BilbaoDynamics/Pinchy/Software/Draw_Matrix/README.md

# Draw Pinchy 

<blockquote class="twitter-tweet" data-lang="es"><p lang="es" dir="ltr">Haciendo integrales en la matriz de <a href="https://twitter.com/hashtag/Pinchy?src=hash">#Pinchy</a> <a href="https://twitter.com/hashtag/teleco?src=hash">#teleco</a> <a href="https://twitter.com/hashtag/PinchyOfThings?src=hash">#PinchyOfThings</a> <a href="https://twitter.com/MakerFaireBio">@MakerFaireBio</a> <a href="https://twitter.com/BilbaoDynamics">@BilbaoDynamics</a> <a href="https://t.co/CbgPX1H6TI">pic.twitter.com/CbgPX1H6TI</a></p>&mdash; Eneko Montero (@EnekoMontero) <a href="https://twitter.com/EnekoMontero/status/799953861096144896">19 de noviembre de 2016</a></blockquote> <script async src="//platform.twitter.com/widgets.js" charset="utf-8"></script>

Program to draw on Pinchy's matrix using your phone.
