BilbaoDynamics/Pinchy/(threads)

Thread 2 (2016-09-29):

Archivos fuentes partes impresas

hulkco, 2016-09-29:
Hola, gracias por compartir su proyecto, podrian compartir los ficheros fuente de las partes impresas y la medida de la Matriz de Leds, gracias

BilbaoDynamics, 2016-09-29:
Buenas tardes Gustavo,

Ante todo muchas gracias por interesarte en el desarrollo de nuestro proyecto. Todos los archivos imprimibles necesarios están en la carpeta Chasis (https://github.com/BilbaoDynamics/Pinchy/tree/master/Chasis). En cuanto a la matriz de LEDs, el driver que utilizamos es este (https://www.sparkfun.com/datasheets/Components/General/COM-09622-MAX7219-MAX7221.pdf) y la matriz esta (https://www.dropbox.com/s/1uju2v4d2x47efw/matriz.pdf?dl=0).

Un saludo, BD team.

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

Closed 2016-09-29.
