BilbaoDynamics/Pinchy/Circuitos/Matrix/matrix.brd

## EAGLE design Circuitos/Matrix/matrix.brd (2016-11-18)

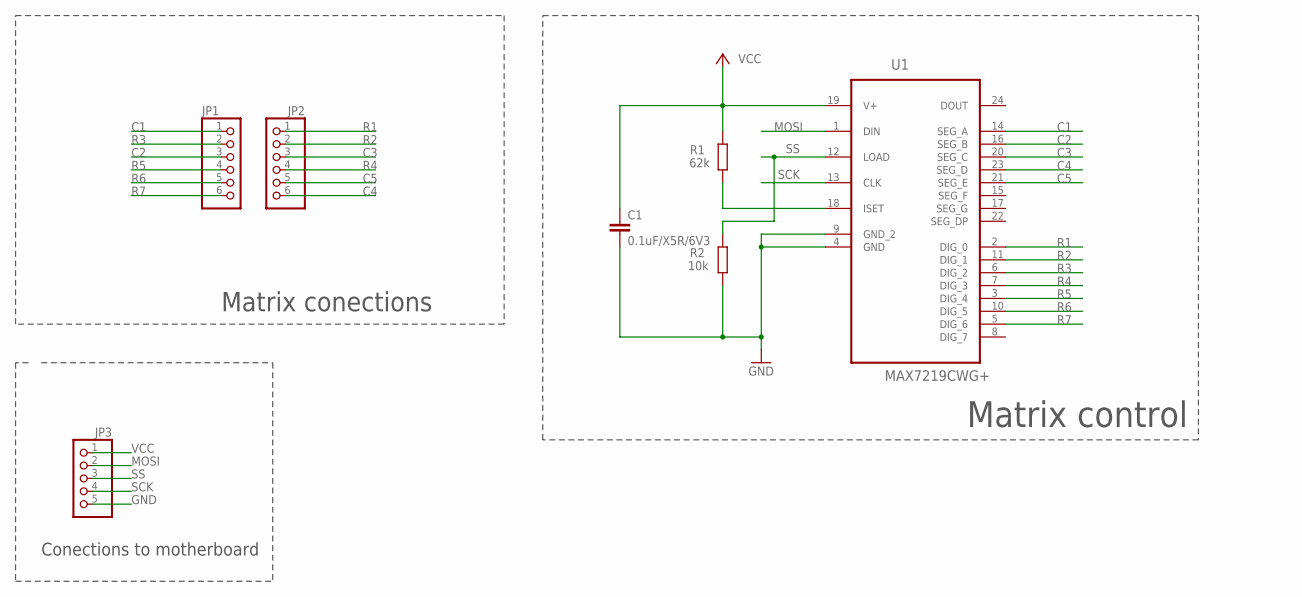
[picture p1: schematic matrix.sch]

Parts:
C1: 0.1uF/X5R/6V3; C1206
JP1, JP2: PINHD-1X6; 1X06
JP3: PINHD-1X5; 1X05
R1: 62k; R0805
R2: 10k; R0805
U1: MAX7219CWG+; SOIC127P1032X265-24N

Connections:
C1: JP1.1, U1.14 (SEG_A)
C2: JP1.3, U1.16 (SEG_B)
C3: JP2.3, U1.20 (SEG_C)
C4: JP2.6, U1.23 (SEG_D)
C5: JP2.5, U1.21 (SEG_E)
GND: C1.2, JP3.5, R2.1, U1.4 (GND), U1.9 (GND_2)
MOSI: JP3.2, U1.1 (DIN)
unnamed: R1.1, U1.18 (ISET)
R1: JP2.1, U1.2 (DIG_0)
R2: JP2.2, U1.11 (DIG_1)
R3: JP1.2, U1.6 (DIG_2)
R4: JP2.4, U1.7 (DIG_3)
R5: JP1.4, U1.3 (DIG_4)
R6: JP1.5, U1.10 (DIG_5)
R7: JP1.6, U1.5 (DIG_6)
SCK: JP3.4, U1.13 (CLK)
SS: JP3.3, R2.2, U1.12 (LOAD)
VCC: C1.1, JP3.1, R1.2, U1.19 (V+)

Notes on the sheet:
Matrix conections
Conections to motherboard
Matrix control

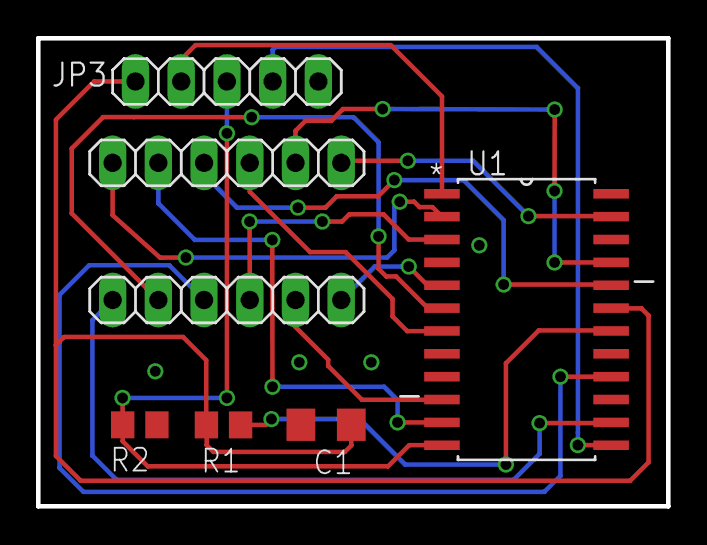
[picture p2: board matrix.brd from above]

Board: 2 copper layers, 35.0 x 26.0 mm, 7 parts (0 on the bottom side), 18 nets.
