BilbaoDynamics/Pinchy/Circuitos/Motherboard/pinchy.brd

## EAGLE design Circuitos/Motherboard/pinchy.brd (2016-11-18)

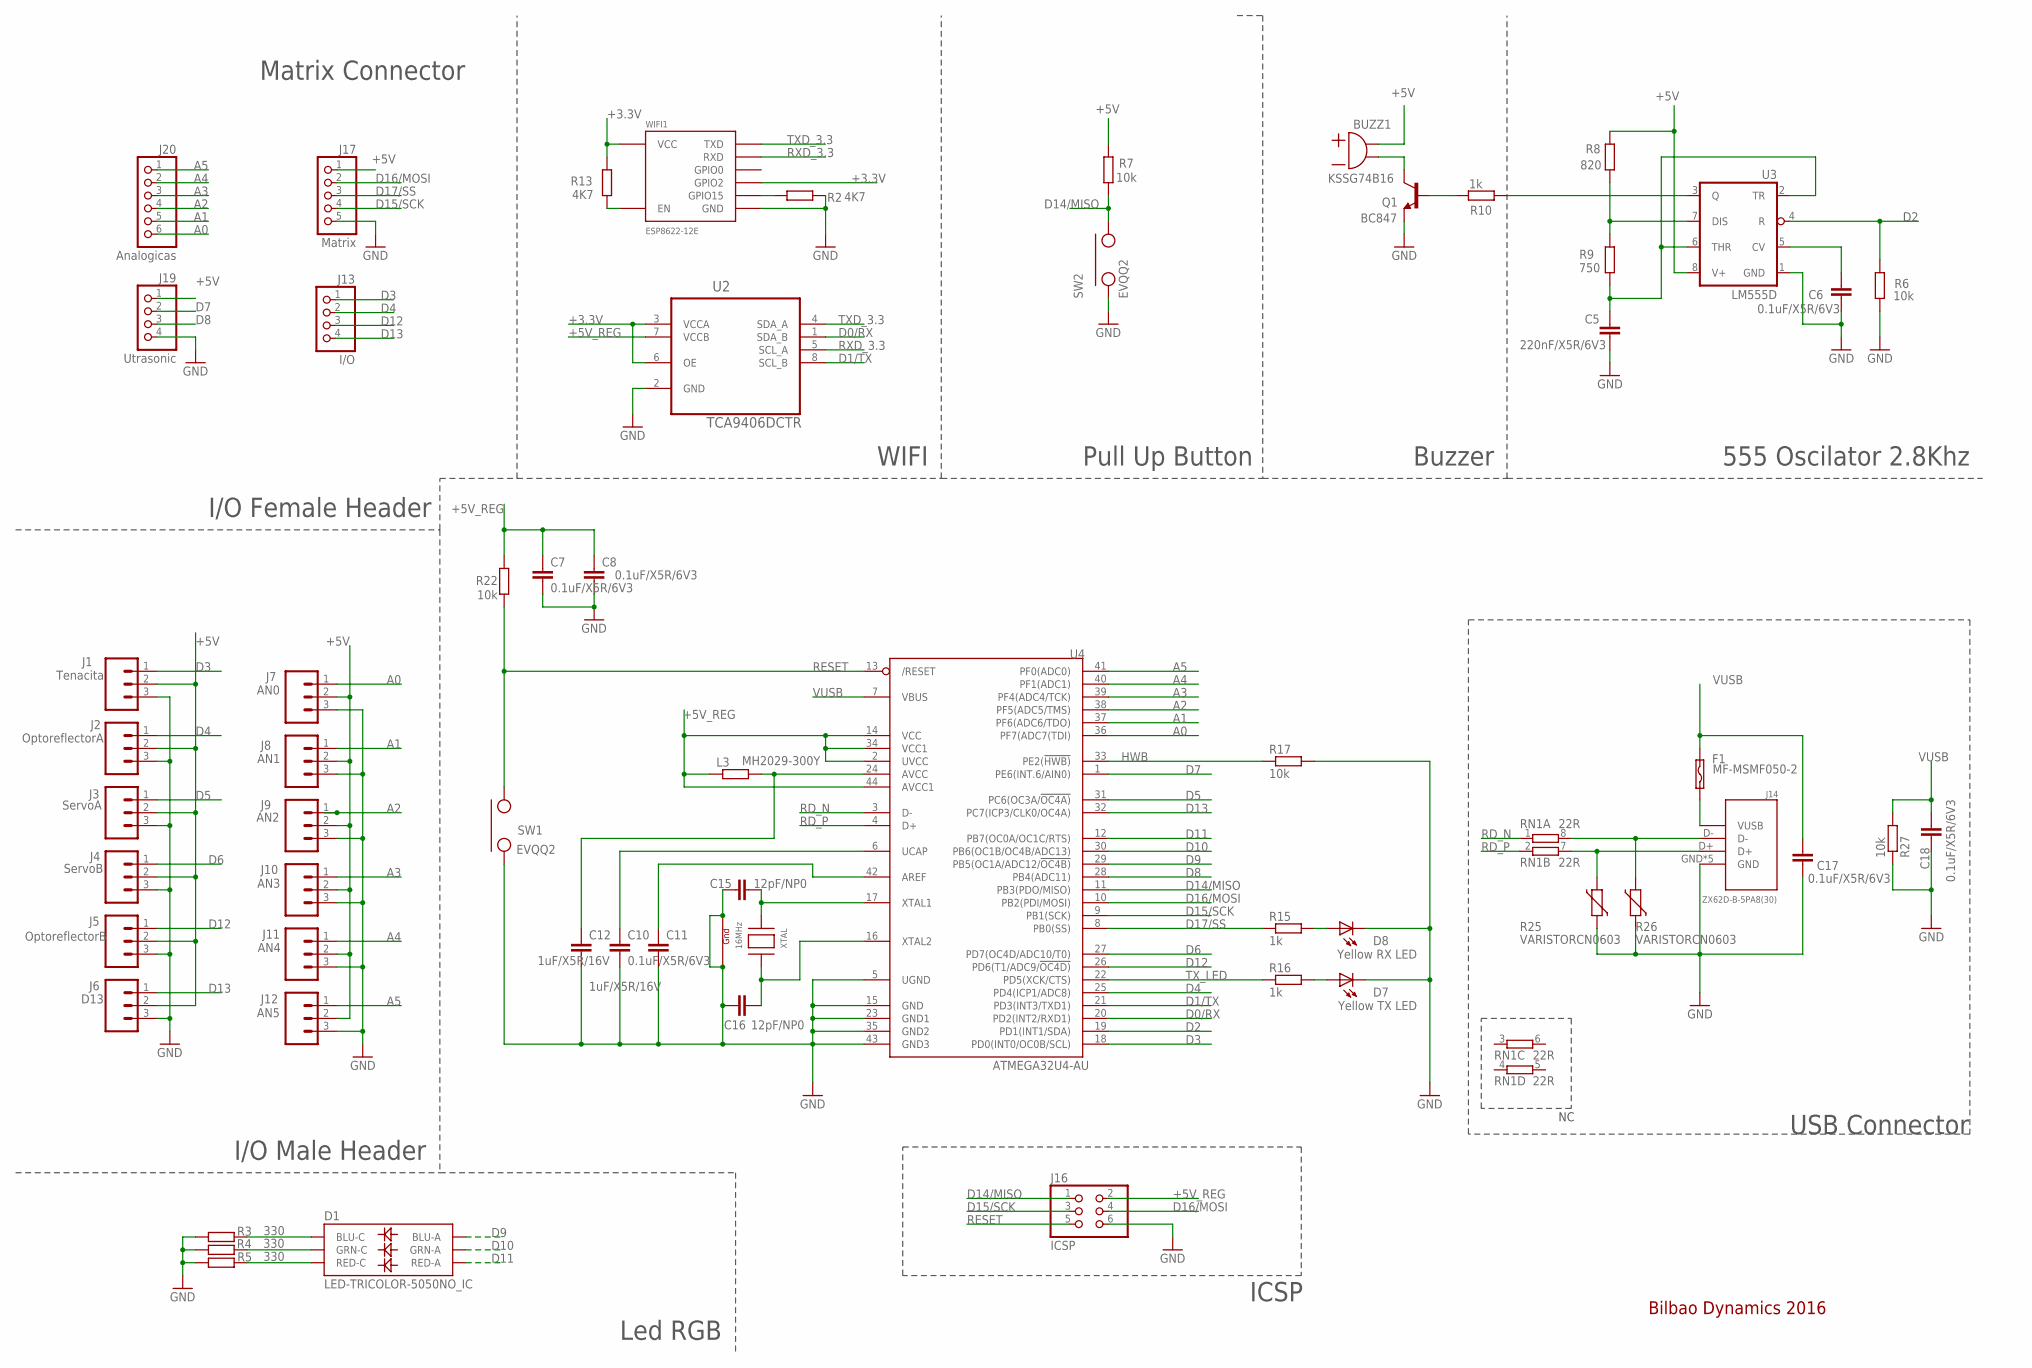
[picture p3: schematic pinchy.sch, sheet 1]

Parts:
BUZZ1: KSSG74B16
C5: 220nF/X5R/6V3; C0805
C6, C7, C8, C11, C18: 0.1uF/X5R/6V3; C0805
C10, C12: 1uF/X5R/16V; C1206
C15, C16: 12pF/NP0; C0805
C17: 0.1uF/X5R/6V3; C1206
D1: LED-TRICOLOR-5050NO_IC; LED-TRICOLOR-5050
D7: Yellow TX LED; CHIPLED_0805
D8: Yellow RX LED; CHIPLED_0805
F1: MF-MSMF050-2; SMD050F
J1: Tenacita; 1X03
J2: OptoreflectorA; 1X03
J3: ServoA; 1X03
J4: ServoB; 1X03
J5: OptoreflectorB; 1X03
J6: D13; 1X03
J7: AN0; 1X03
J8: AN1; 1X03
J9: AN2; 1X03
J10: AN3; 1X03
J11: AN4; 1X03
J12: AN5; 1X03
J13: I/O; 1X04
J14: ZX62D-B-5PA8(30)
J16: ICSP; 2X03
J17: Matrix; 1X05
J19: Utrasonic; 1X04
J20: Analogicas; 1X06
L3: MH2029-300Y; R0805
Q1: BC847; SOT23
R2, R13: 4K7; R0805
R3, R4, R5: 330; R0805
R6, R7, R17, R22, R27: 10k; R0805
R8: 820; R0805
R9: 750; R0805
R10, R15, R16: 1k; R0805
R25, R26: VARISTORCN0603; CT/CN0603
RN1: 22R; CAY16
SW1, SW2: EVQQ2; JAEGGER_MKII_EVQQ2
U2: TCA9406DCTR; SOP65P400X130-8N
U3: LM555D; SO08
U4: ATMEGA32U4-AU; TQFP44
WIFI1: ESP8622-12E
XTAL: 16MHz; NX3225

Connections:
+3.3V: R13.2, U2.3 (VCCA), U2.6 (OE), WIFI1.GPIO2, WIFI1.VCC; also elsewhere on the board
+5V: BUZZ1.P$2 (2), BUZZ1.P$3 (2), J1.2, J2.2, J3.2, J4.2, J5.2, J6.2, J7.2, J8.2, J9.2, J10.2, J11.2, J12.2, J17.1, J19.1, R7.2, R8.2, U3.8 (V+); also elsewhere on the board
+5V_REG: C7.1, C8.1, J16.2, L3.1, R22.2, U2.7 (VCCB), U4.2 (UVCC), U4.14 (VCC), U4.34 (VCC1), U4.44 (AVCC1); also elsewhere on the board
A0: J7.1, J20.6, U4.36 (PF7(ADC7(TDI))
A1: J8.1, J20.5, U4.37 (PF6(ADC6/TDO))
A2: J9.1, J20.4, U4.38 (PF5(ADC5/TMS))
A3: J10.1, J20.3, U4.39 (PF4(ADC4/TCK))
A4: J11.1, J20.2, U4.40 (PF1(ADC1))
A5: J12.1, J20.1, U4.41 (PF0(ADC0))
D0/RX: U2.1 (SDA_B), U4.20 (PD2(INT2/RXD1))
D1/TX: U2.8 (SCL_B), U4.21 (PD3(INT3/TXD1))
D2: R6.1, U3.4 (R), U4.19 (PD1(INT1/SDA))
D3: J1.1, J13.1, U4.18 (PD0(INT0/OC0B/SCL))
D4: J2.1, J13.2, U4.25 (PD4(ICP1/ADC8))
D5: J3.1, U4.31 (PC6(OC3A/!OC4A))
D6: J4.1, U4.27 (PD7(OC4D/ADC10/T0))
D7: J19.2, U4.1 (PE6(INT.6/AIN0))
D8: J19.3, U4.28 (PB4(ADC11))
D9: D1.3 (BLU-A), U4.29 (PB5(OC1A/ADC12/!OC4B))
D10: D1.1 (GRN-A), U4.30 (PB6(OC1B/OC4B/ADC13))
D11: D1.2 (RED-A), U4.12 (PB7(OC0A/OC1C/RTS))
D12: J5.1, J13.3, U4.26 (PD6(T1/ADC9/!OC4D))
D13: J6.1, J13.4, U4.32 (PC7(ICP3/CLK0/OC4A))
D14/MISO: J16.1, R7.1, SW2.P$1, SW2.P$4, U4.11 (PB3(PDO/MISO))
D15/SCK: J16.3, J17.4, U4.9 (PB1(SCK))
D16/MOSI: J16.4, J17.2, U4.10 (PB2(PDI/MOSI))
D17/SS: J17.3, R15.1, U4.8 (PB0(SS))
GND: C5.2, C6.2, C7.2, C8.2, C10.2, C11.2, C12.2, C15.2, C16.2, C17.2, C18.2, D7.C, D8.C, J1.3, J2.3, J3.3, J4.3, J5.3, J6.3, J7.3, J8.3, J9.3, J10.3, J11.3, J12.3, J14.GND, J14.P$1 (GND), J14.P$2 (GND), J14.P$6 (GND), J14.P$7 (GND), J16.6, J17.5, J19.4, Q1.2 (E), R2.2, R3.1, R4.1, R5.1, R6.2, R17.2, R25.1, R26.1, R27.1, SW1.P$2, SW1.P$3, SW2.P$2, SW2.P$3, U2.2 (GND), U3.1 (GND), U4.5 (UGND), U4.15 (GND), U4.23 (GND1), U4.35 (GND2), U4.43 (GND3), WIFI1.GND, XTAL.2 (G2), XTAL.4 (G1); also elsewhere on the board
HWB: R17.1, U4.33 (PE2(!HWB))
unnamed: R8.1, R9.2, U3.7 (DIS)
unnamed: R10.2, U3.3 (Q)
unnamed: D1.4 (BLU-C), R3.2
unnamed: D1.6 (GRN-C), R4.2
unnamed: D1.5 (RED-C), R5.2
unnamed: R13.1, WIFI1.EN
unnamed: BUZZ1.P$1 (1), BUZZ1.P$4 (1), Q1.3 (C)
unnamed: C5.1, R9.1, U3.2 (TR), U3.6 (THR)
unnamed: C6.1, U3.5 (CV)
unnamed: Q1.1 (B), R10.1
unnamed: R2.1, WIFI1.GPIO15
unnamed: J14.D+, R25.2, RN1.7 (2)
unnamed: J14.D-, R26.2, RN1.8 (2)
unnamed: F1.1, J14.VUSB
unnamed: C15.1, U4.17 (XTAL1), XTAL.1 (X1)
unnamed: C16.1, U4.16 (XTAL2), XTAL.3 (X2)
unnamed: C10.1, U4.6 (UCAP)
unnamed: C12.1, L3.2, U4.24 (AVCC)
unnamed: D8.A, R15.2
unnamed: D7.A, R16.2
RD_N: RN1.1, U4.3 (D-)
RD_P: RN1.2 (1), U4.4 (D+)
RESET: J16.5, R22.1, SW1.P$1, SW1.P$4, U4.13 (/RESET)
RXD_3.3: U2.5 (SCL_A), WIFI1.RXD
TXD_3.3: U2.4 (SDA_A), WIFI1.TXD
TX_LED: R16.1, U4.22 (PD5(XCK/CTS))
U4: C11.1, U4.42 (AREF)
VUSB: C17.1, C18.1, F1.2, R27.2, U4.7 (VBUS); also elsewhere on the board

Notes on the sheet:
Bilbao Dynamics 2016
Led RGB
Pull Up Button
I/O Male Header
I/O Female Header
555 Oscilator 2.8Khz
Buzzer
ICSP
Matrix Connector
USB Connector
WIFI

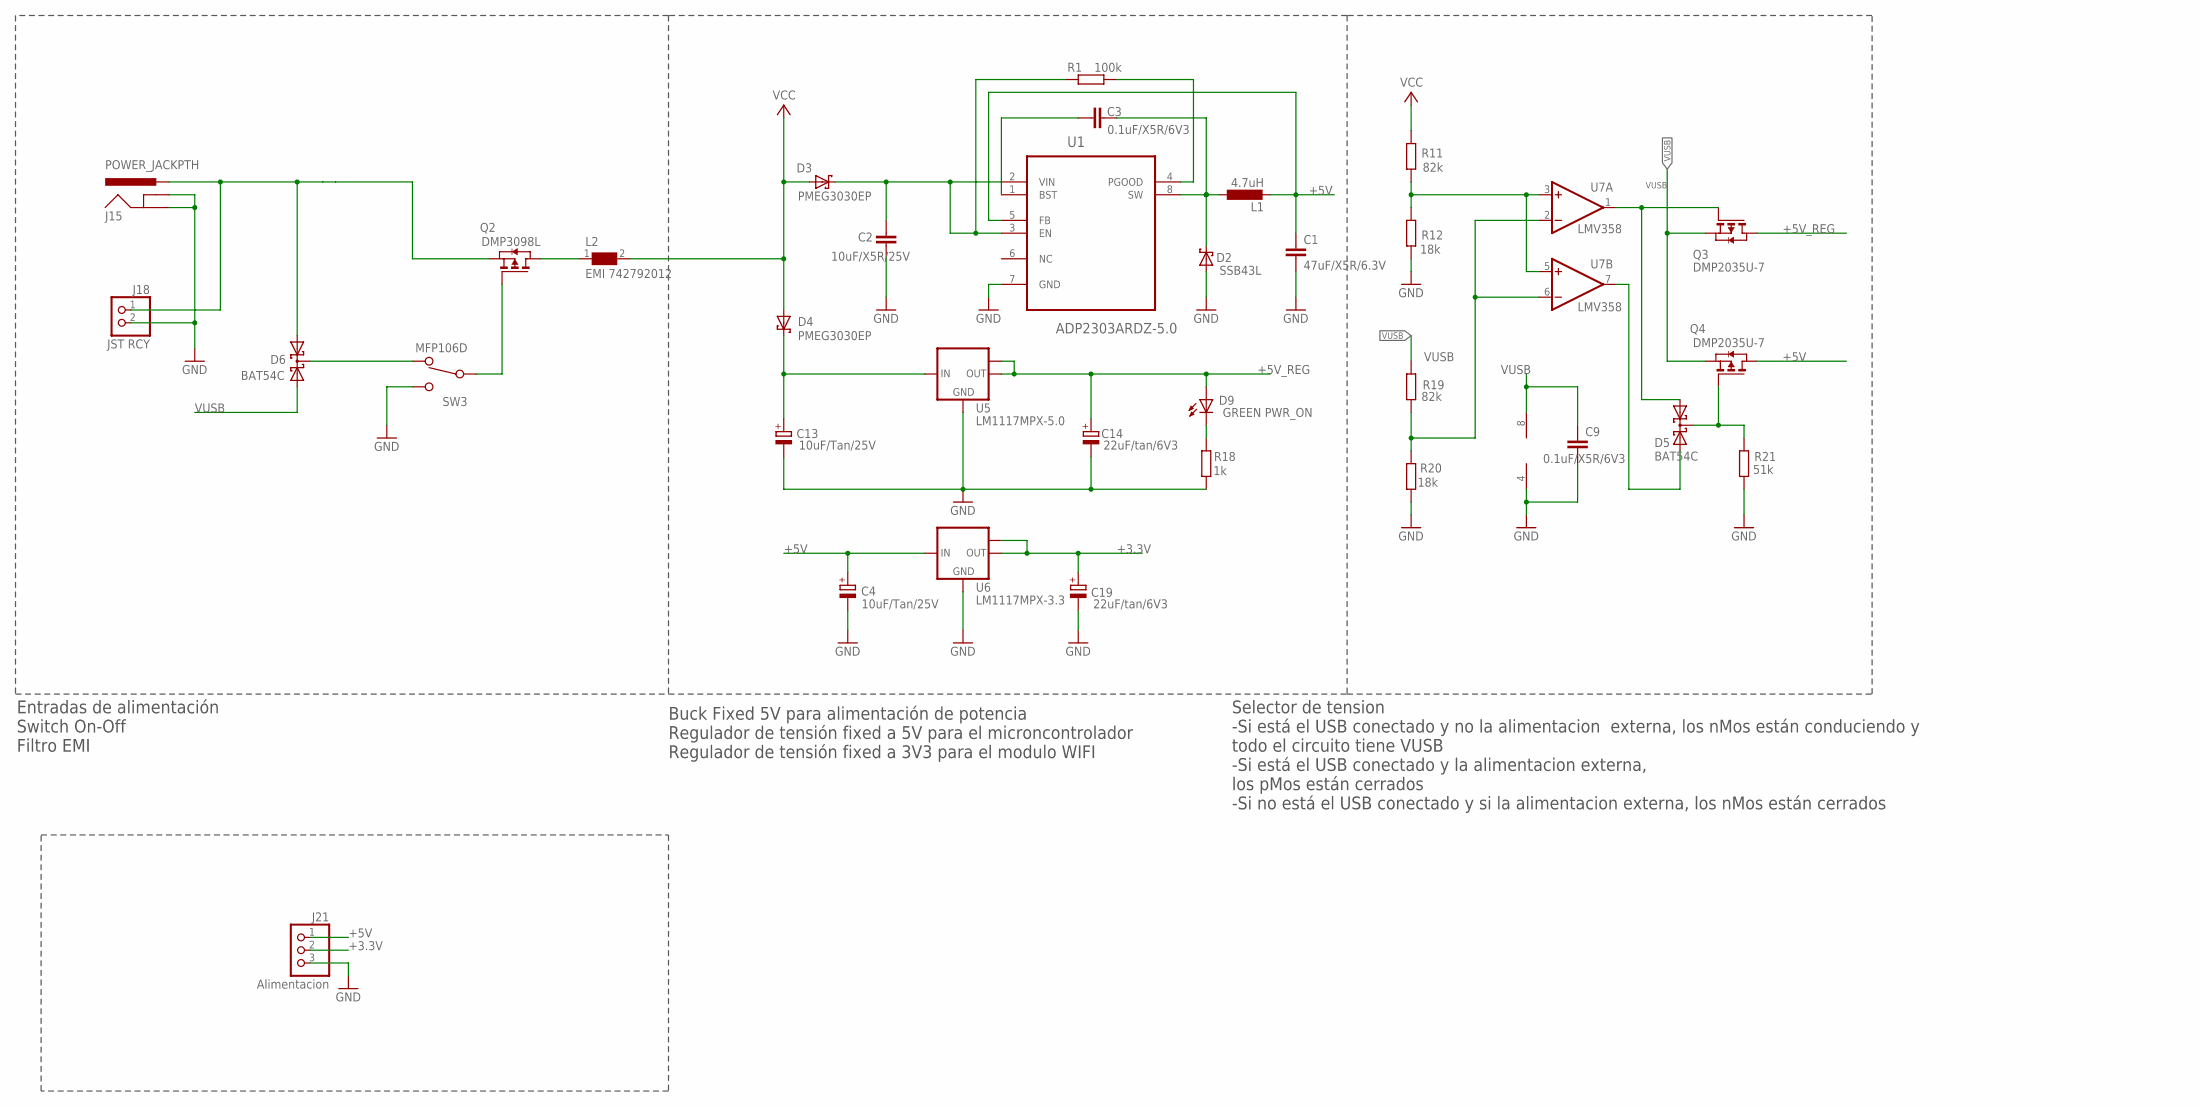
[picture p4: schematic pinchy.sch, sheet 2]

Parts:
C1: 47uF/X5R/6.3V; C1210
C2: 10uF/X5R/25V; C0805
C3, C9: 0.1uF/X5R/6V3; C0805
C4, C13: 10uF/Tan/25V; C1206-POL
C14, C19: 22uF/tan/6V3; C1206-POL
D2: SSB43L
D3, D4: PMEG3030EP; SMB
D5, D6: BAT54C; SOT23
D9: GREEN PWR_ON; CHIPLED_0805
J15: POWER_JACKPTH; POWER_JACK_PTH
J18: JST RCY; 1X02
J21: Alimentacion; 1X03
L1: 4.7uH; TDK_VLF10040T_4R7N5R4
L2: EMI 742792012; 0805
Q2: DMP3098L; SOT-23
Q3, Q4: DMP2035U-7; SOT-23
R1: 100k; R0805
R11, R19: 82k; R0805
R12, R20: 18k; R0805
R18: 1k; R0805
R21: 51k; R0805
SW3: MFP106D
U1: ADP2303ARDZ-5.0; SOIC127P600X175-9N
U5: LM1117MPX-5.0; SOT223
U6: LM1117MPX-3.3; SOT223
U7: LMV358; SO08

Connections:
+3.3V: C19.2 (+), J21.2, U6.2 (OUT), U6.TAB (OUT1); also elsewhere on the board
+5V: C1.1, C4.2 (+), J21.1, L1.2, Q4.1 (D), U1.5 (FB), U6.3 (IN); also elsewhere on the board
+5V_REG: C14.2 (+), D9.A, Q3.1 (D), U5.2 (OUT), U5.TAB (OUT1); also elsewhere on the board
GND: C1.2, C2.2, C4.1 (-), C9.2, C13.1 (-), C14.1 (-), C19.1 (-), D2.2 (A), J15.GND, J15.GNDBREAK, J18.2, J21.3, R12.1, R18.1, R20.1, R21.1, SW3.2, U1.7 (GND), U5.1 (GND), U6.1 (GND), U7.4 (V-); also elsewhere on the board
unnamed: C2.1, D3.C, R1.2, U1.2 (VIN), U1.3 (EN)
unnamed: R1.1, U1.4 (PGOOD)
unnamed: C3.2, D2.1 (C), L1.1, U1.8 (SW)
unnamed: D6.1 (A1), J15.PWR, J18.1, Q2.2 (S)
unnamed: D5.3 (CC), Q4.3 (G), R21.2
unnamed: L2.1, Q2.1 (D)
unnamed: R11.1, R12.2, U7.3 (+IN), U7.5 (+IN)
unnamed: C3.1, U1.1 (BST)
unnamed: D5.1 (A1), Q3.3 (G), U7.1 (OUT)
unnamed: Q2.3 (G), SW3.COM
unnamed: D6.3 (CC), SW3.1
unnamed: C13.2 (+), D4.C, U5.3 (IN)
unnamed: D9.C, R18.2
unnamed: D5.2 (A2), U7.7 (OUT)
unnamed: R19.1, R20.2, U7.2 (-IN), U7.6 (-IN)
VCC: D3.A, D4.A, L2.2, R11.2
VUSB: C9.1, D6.2 (A2), Q3.2 (S), Q4.2 (S), R19.2, U7.8 (V+); also elsewhere on the board

Notes on the sheet:
Entradas de alimentación Switch On-Off Filtro EMI
Buck Fixed 5V para alimentación de potencia Regulador de tensión fixed a 5V para el microncontrolador Regulador de tensión fixed a 3V3 para el modulo WIFI
Selector de tension -Si está el USB conectado y no la alimentacion externa, los nMos están conduciendo y todo el circuito tiene VUSB -Si está el USB conectado y la alimentacion externa, los pMos están cerrados -Si no está el USB conectado y si la alimentacion externa, los nMos están cerrados

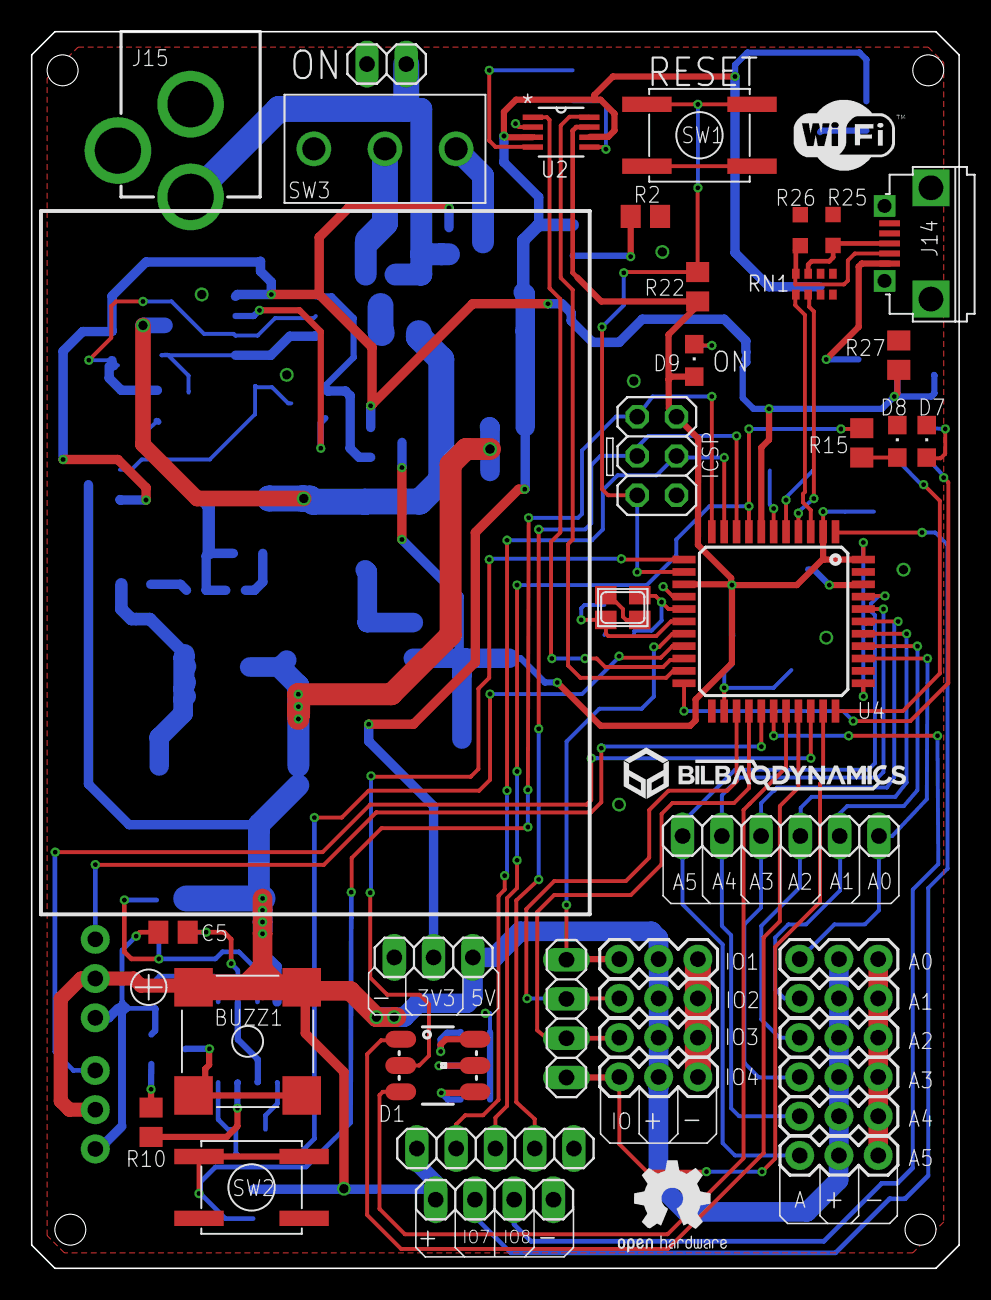
[picture p5: board pinchy.brd from above]

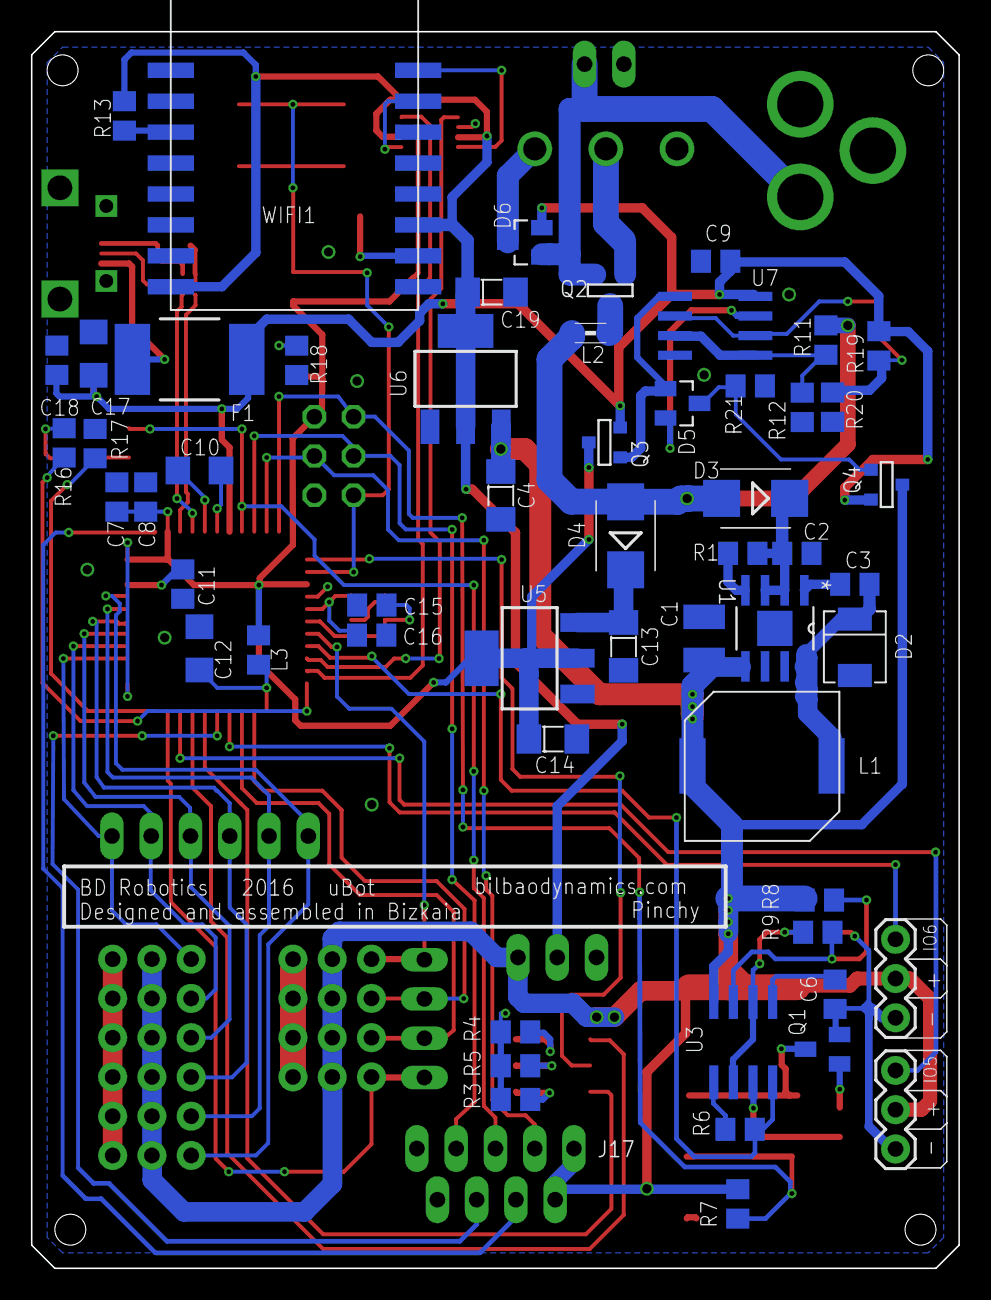
[picture p6: board pinchy.brd from below]

Board: 2 copper layers, 60.0 x 80.0 mm, 95 parts (56 on the bottom side), 73 nets.
