BilbaoDynamics/Pinchy/Circuitos/Optorreflector/optoreflector.brd

## EAGLE design Circuitos/Optorreflector/optoreflector.brd (2016-11-18)

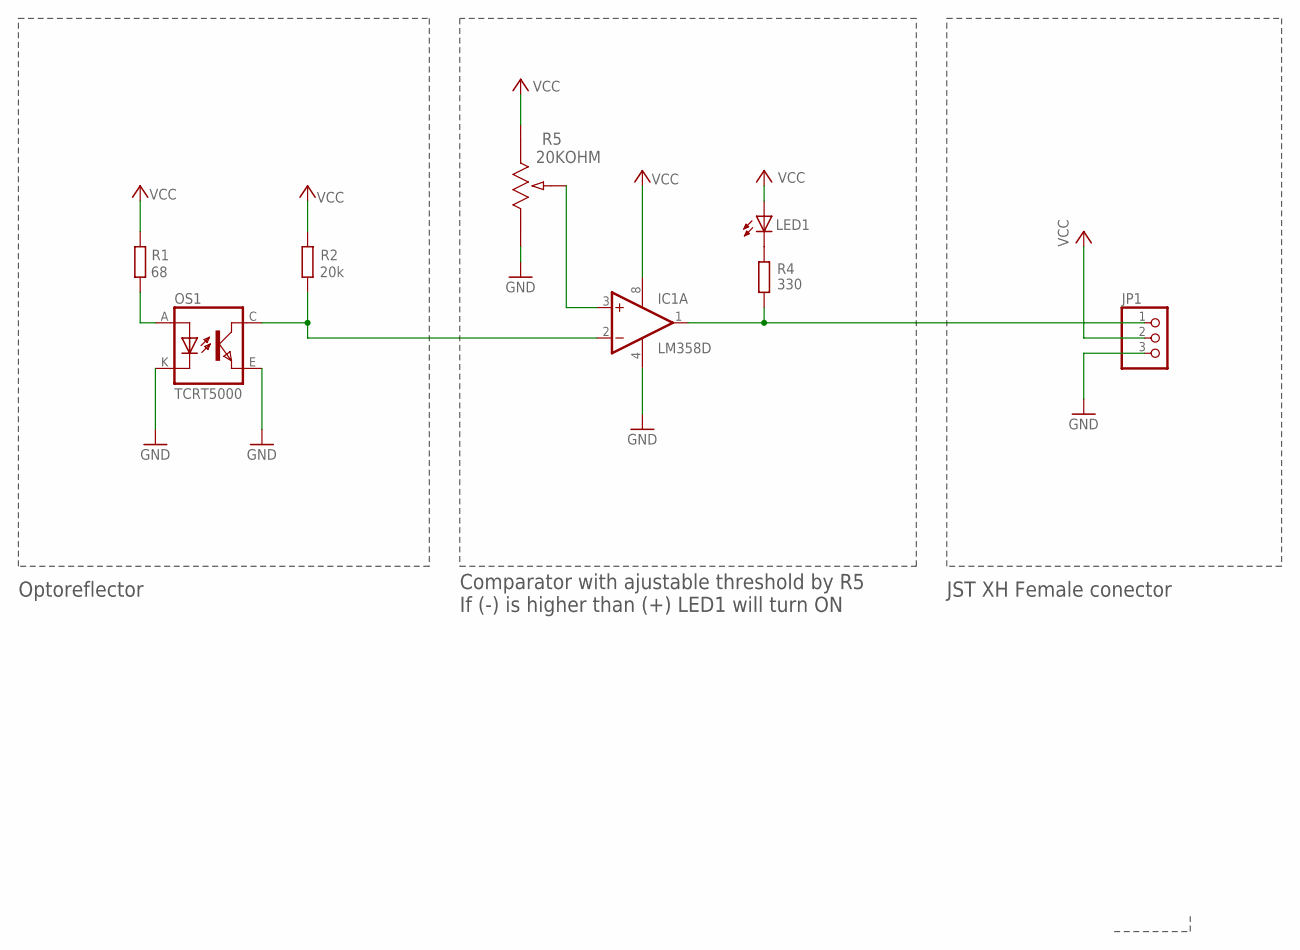
[picture p7: schematic optoreflector.sch]

Parts:
IC1: LM358D; SO08
JP1: PINHD-1X3; 1X03
LED1: LEDCHIP-LED0805; CHIP-LED0805
OS1: TCRT5000
R1: 68; R0805
R2: 20k; R0805
R4: 330; R0805
R5: 20KOHM; POT_EVM2W

Connections:
GND: IC1.4 (V-), JP1.3, OS1.E (EMITTER), OS1.K (CATHODE), R5.3
unnamed: LED1.C, R4.2
unnamed: OS1.A (ANODE), R1.1
unnamed: IC1.2 (-IN), OS1.C (COLLECTOR), R2.1
unnamed: IC1.3 (+IN), R5.2
unnamed: IC1.1 (OUT), JP1.1, R4.1
VCC: IC1.8 (V+), JP1.2, LED1.A, R1.2, R2.2, R5.1

Notes on the sheet:
Optoreflector
JST XH Female conector
Comparator with ajustable threshold by R5 If (-) is higher than (+) LED1 will turn ON

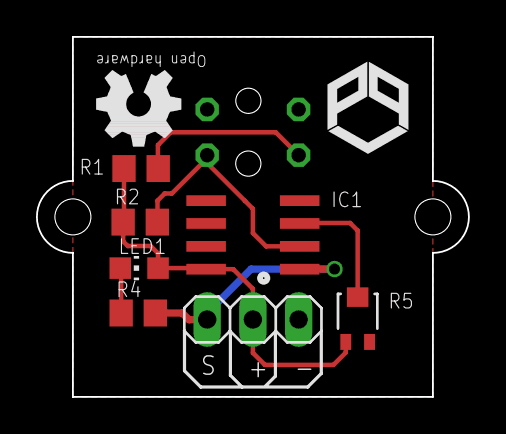
[picture p8: board optoreflector.brd from above]

Board: 2 copper layers, 24.0 x 20.0 mm, 8 parts (1 on the bottom side), 7 nets.
