BilbaoDynamics/Pinchy/Software/Draw_Matrix/arduinoPinchy/mf-animacion.ino

#include <PinchyMatrix.h>


PinchyMatrix pm = PinchyMatrix(16, 15, 17);

void setup() {
  pm.shutdown(false);
  pm.setIntensity(15);
}

void loop() {
  pm.binary("10000001000000000000000000001000000");sleepp();
  pm.binary("11000001100000100000010000000100000");sleepp();
  pm.binary("01100000110000010000001000001010000");sleepp();
  pm.binary("00110000011000001000000100000101000");sleepp();
  pm.binary("00011000001100000100000010000010100");sleepp();
  pm.binary("00001100000110000010000001000001010");sleepp();
  pm.binary("00011000001100000010000001000001010");sleepp();
  pm.binary("00001100000110000010000001000001010");sleepp();
  pm.binary("00110000011000000100000010000010100");sleepp();
  pm.binary("01100000110000001000000100000101000");sleepp();
  pm.binary("00110000011000001000000100000101000");sleepp();
  pm.binary("01100000110000001000000100000101000");sleepp();
  pm.binary("00110000011000001000000100000101000");sleepp();
  pm.binary("00011000001100000100000010000010100");sleepp();
  pm.binary("00001100000110000010000001000001010");sleepp();
  pm.binary("00000110000011000001000000100000101");sleepp();
  pm.binary("00000010000001000000100000010000010");sleepp();
  pm.binary("00000000000000000000000000000000001");sleepp();
  pm.binary("00000000000000000000000000000000001");sleepp();
}

void sleepp(){
  delay(400);
}
