BilbaoDynamics/Pinchy/(commit log)

2016-11-18 ❌ Deleted unused files
    [matrix.brd, matrix.sch, optoreflector.brd, optoreflector.sch, pinchy.brd, pinchy.sch, tenacitas.brd]
2016-11-18 🚀 Updated for the newest version of Pinchy
    [matrix.brd, matrix.sch, optoreflector.brd, optoreflector.sch, pinchy.brd, pinchy.sch]
2016-11-20 Sistema WEB -(internet)-> OpenServer -(Internet)-> NattedServer -(wifi/serial)-> Arduino
